Berg0162/Simcline-V3/src/config/README.md

# Central configuration

# configBoard.h
Simcline-V3 <b>Board</b> configuration options:
```C++
// Define the board here, that is part of your system setup
//#define XIAO_ESP32S3
//#define LILYGO_T_DISPLAY_S3
//#define ADAFRUIT_FEATHER_ESP32_S3
//#define ADAFRUIT_FEATHER_ESP32_V2
#define YOUR_ESP32_BOARD
```
# configDisplay.h
Simcline-V3 <b>Display</b> configuration options:
```C++
// Define the display, that is part of your system setup
#define NODISPLAY
//#define OLEDSSD1306_128x64
//#define LILYGO_T_DISPLAY_S3
//#define YOURDISPLAY
//#define SERIALDISPLAY
```
<b>Warning</b>: When a new version of Simcline-V3 is installed in Arduino IDE 2 it will override <b>ALL</b> files of a previous version! If you have made modifications in a file that is part of `Simcline-V3` --> <b>Make</b> a <b>copy</b> of the file(s) in question <b>BEFORE</b> you <b>install</b> a new library version!

# configNimBLE.h
Simcline-V3 <b>NimBLE</b> configuration options:
```C++
// ----------------------------------------------------------------------------------------
// Your FIXED hardware Laptop/Trainer/Smartphone BLE MAC- or DEVICE-Addresses 
// Enter address string here like the printed format like [00:01:02:03:04:05 0]
// LAPTOP Fixed Device Address --------Public Type (0) --------- Random Type (1)-----------
//#define LAPTOPADDRESS "00:01:02:03:04:05 0" // Example Mac string of Public Type

// TRAINER Fixed Device Address --------Public Type (0) --------- Random Type (1)----------
//#define TRAINERADDRESS "00:01:02:03:04:05 0"  // Example Mac string of Public Type

```

# configSimcline.h
Simcline-V3 <b>Mechanical SIMCLINE 2.0</b> configuration options:
```C++
//------------- Range Control definitions for high level movement control -----------------------------------------------
// In theory the RawgradeValue varies between 0 (equals -200% grade) and 40000 (equals +200% grade)
// SIMCLINE is mechanically working between -10% and +20% --> 19000 and 22000

//------------------------------------------------- WARNING --------------------------------------------------------------
//------------ SET THESE TWO VALUES IN ACCORDANCE WITH THE MECHANICAL RANGE LIMITATIONS OF YOUR SIMCLINE !!! -------------
// Raw Grade Value Minimally (Mechanically: the lowest position of wheel axis)  19000 is equiv. of 10% downhill road grade
#define RGVMIN 19500 // -5%  // Always is RGVMIN < 20000 (flat road level)
// Raw Grade Value Maximally (Mechanically: the highest position of wheel axis) 22000 is equiv. of 20% uphill road grade
#define RGVMAX 22000 // 20%  // +20% // Always is RGVMAX > 20000 (flat road level)
//------------------------------------------------- WARNING --------------------------------------------------------------

// Correction for the difference between the measuring plane and the middle
// wheel-axis position. A 1 cm offset corresponds to a MEASUREOFFSET of about 40.
#define MEASUREOFFSET 0

// -------------------------- WARNING ------------------------------------------------------------
// The following VL6180X sensor values are entirely construction specific and
// should be experimentally determined, when the Actuator AND the VL6180X sensor are mounted!
// ------>>>> Test manually and use example/test sketches that go with the VL6180X sensor! <<<<---
// Microswitches should limit physically/mechanically the upper and lower position of the Actuator!
// The microswitches are mechanically controlled, and NOT by the software --> should be fail safe!
// Notice that unrestricted movement at the boundaries can damage the Actuator and/or construction!
// The following values are respected by the software and will (in normal cases!) never be exceeded!
#define MINPOSITION 100  // VL6180X highest value top microswitch activated to mechanically stop operation
#define MAXPOSITION 200  // VL6180X lowest value bottom microswitch activated to mechanically stop operation

// -------------------------- WARNING ------------------------------------------------------------
// Operational boundaries of the VL6180X sensor are used/set in class Lifter after calling its "init".
// A safe measuring range of up to 30 cm of total movement is recommended for the VL6180X sensor setting!
//
// Bandwidth is used in the code to take measuring errors and a safe margin into account when reaching
// the above defined max or min positions of the construction! The software does painstakingly respect
// these and is independent of the appropriate working of the microswitches when reaching the boundaries!
// These microswitches are a SECOND line of defence against out of range and potentially damaging movement!
#define BANDWIDTH 4 
```
<b>Warning</b>: When a new version of Simcline-V3 is installed in Arduino IDE 2 it will override <b>ALL</b> files of a previous version! If you have made modifications in a file that is part of `Simcline-V3` --> <b>Make</b> a <b>copy</b> of the file(s) in question <b>BEFORE</b> you <b>install</b> a new library version!

# configPortal.h
Simcline-V3 <b>WiFi Portal</b> configuration options:
```C++
// Enable the startup WiFi configuration portal only on builds that have enough
// IRAM headroom for WiFi + NimBLE. Classic ESP32 builds can overflow IRAM with
// the current MITM feature set, even with a minimal WiFiServer portal.
//
// Uncomment to force-enable after testing the selected board/core combination.
//#define ENABLE_CONFIG_PORTAL

// Access Point SSID and password used by the startup configuration portal.
#define PORTAL_APPNAME 	"SimclineCfg"
#define PORTAL_PASSWORD "12345678"

// Enable automatically for newer ESP32 targets that are better suited to
// combining WiFi, NimBLE, and display code. Keep classic ESP32 excluded unless
// explicitly force-enabled above because it has shown IRAM overflow here.
#if defined(CONFIG_IDF_TARGET_ESP32S3) || \
    defined(CONFIG_IDF_TARGET_ESP32C3)  || \
    defined(CONFIG_IDF_TARGET_ESP32C5)  || \
    defined(CONFIG_IDF_TARGET_ESP32C6)  || \
    defined(CONFIG_IDF_TARGET_ESP32C61)
#define ENABLE_CONFIG_PORTAL
#endif

```

# configDebug.h
Simcline-V3 has a fine-grained scheme for allowing debug-messages during operation. Every `/src/<file name>.cpp` has its own <b>#define DEBUG</b> at the beginning of the code that can be (un)commented (switched on or off) discretionary. However, when one reaches the state that debugging has no longer a purpose, you want to get rid of all the overhead (processor load) and optimise for speed. This `configDebug.h` allows you to switch OFF in one place <b>all Simcline-V3 debugging messages</b> with one <b>master switch</b>.<br>
Simcline-V3 <b>Debug</b> configuration options:
```C++
// ------------------------------------------------------------------------------------------------
// COMPILER DIRECTIVE to allow/suppress ALL DEBUG messages that help to debug code sections
// Uncomment general "#define GLOBAL_DEBUG" to activate the Simcline-V3 debug master switch...
#define GLOBAL_DEBUG

```
