Berg0162/Simcline-V3/docs/XIAO_ESP32S3_Sense.md

# SIMCLINE Icon &nbsp; SIMCLINE-V3 for Bluetooth Smart trainers <br> based on the Seeed Studio XIAO ESP32-S3 board with OLED display.

# Setup XIAO ESP32-S3 for Simcline-V3
The board and display to work with can be activated in Simcline-V3 with the right settings.<br>
1) Open file, edit and save(!): `src/config/configBoard.h`
```C++
// ------------------------------------------------------------------------------------------------
// Define the board here, that is part of your system setup
#define XIAO_ESP32S3
//#define LILYGO_T_DISPLAY_S3
//#define ADAFRUIT_FEATHER_ESP32_S3
//#define ADAFRUIT_FEATHER_ESP32_V2
//#define YOUR_ESP32_BOARD
```
2) Open file, edit and save(!): `src/config/configDisplay.h`<br>
```C++
// ------------------------------------------------------------------------------------------------
// Define the display, that is part of your system setup
//#define NODISPLAY
#define OLEDSSD1306_128x64
//#define LILYGO_T_DISPLAY_S3
//#define YOURDISPLAY
//#define SERIALDISPLAY
// ------------------------------------------------------------------------------------------------
```
<b>Warning</b>: When a new version of Simcline-V3 is installed in Arduino IDE 2 it will override <b>ALL</b> files of a previous version! If you have made modifications in a file that is part of `Simcline-V3` --> <b>Make</b> a <b>copy</b> of the file(s) in question <b>BEFORE</b> you <b>install</b> a new library version!

## Arduino IDE 2.x
The present code is developed on Arduino IDE 2. Notice that you will need an Arduino IDE that is tailored for this specific <b>Seeed Studio XIAO ESP32-S3</b> processor! Please follow the installation instructions for the [Seeed Studio XIAO ESP32-S3](https://wiki.seeedstudio.com/xiao_esp32s3_getting_started/)<br>

## Before you start
If you select in the menu bar of Arduino IDE 2 <b>Tools</b>, the settings for the <b>XIAO_ESP32-S3</b> processor and the project are the following:
<p align=center>
XIAO_ESP32-S3 Tools Menu
</p>
<br clear="left">

# XIAO ESP32-S3 pinout

XIAO ESP32-S3 pinout

# Electronic components and wiring for the SIMCLINE 2.0 mechanical system<br>

Circuitry version 2.0

In this setup is chosen for the well-known 4 compact active components plus XIAO ESP32-S3 that are used in the SIMCLINE project and that can finally all be mounted inside the components box (designed for use with the Adafruit Feather formfactor). NOTICE: the thumb-sized XIAO ESP32-S3 needs your special care to be mounted stably inside.<br clear="right">

<b>Adafruit DRV8871 DC Motor Driver</b><br>
A small one channel motor driver for 12 V (6.5 - 48 V) and 3,6 Amperes max. This board enables the processor to set the Actuator motor in up or down movement. It transforms logical digital levels (Go Up, Go Down and Stop) from the ESP32-S3 to switching of 12 Volt at 3,6 Amperes max., the levels at which the Actuator works. Notice that default the board comes limited to 2,6 Amperes and you need to add a resistor to set for max current level. Install Vertical Through Hole Male PCB Header Pins on the board; this will allow correct mounting of the board inside the components box!<br>

<b>Seeed Studio XIAO ESP32-S3</b><br>
During years we have gained a lot of experience with the very stable and reliable <b>Seeed Studio XIAO ESP32-S3 Sense</b> - in different projects. Without the video camera the board does not need an extra heatsink is my experience!
- Powerful MCU Board: Incorporate the ESP32-S3 32-bit, dual-core, Xtensa processor chip operating up to 240 MHz, mounted multiple development ports, Arduino / MicroPython supported
- With Sense extension board: intergrating additional digital microphone (NOT USED)
- Great Memory for more Possibilities: Offer 8MB PSRAM and 8MB FLASH (16MB in Plus version), supporting SD card slot for external 32GB FAT memory (only for XIAO ESP32-S3)
- Outstanding RF performance: Support 2.4GHz Wi-Fi and BLE dual wireless communication, support 100m+ remote communication when connected with U.FL antenna
- Thumb-sized Compact Design: 21 x 17.8mm, adopting the classic form factor of XIAO, suitable for space limited projects like wearable devices
[Seeed Studio XIAO ESP32-S3](https://wiki.seeedstudio.com/xiao_esp32s3_getting_started/) <br>

<b>OLED display blue/white 128x64 pixels (0,96 Inch, I2C)</b><br>
Small display board has a critical overall board size of 25 mm * 27 mm (!); (See for example: [Webshop](https://www.gadgetbouw.nl/shop/0-96inch-128x64-i2c-oled-scherm-ssd1306-wit-of-blauw)). Display area itself is: 25 mm x 14 mm. Shows cycling data and diagnostic info that is gathered during operation by the ESP32-S3 to inform the SIMCLINE user about relevant information. NOTICE: a) Many different formfactors are offered at webshops; b) Install Vertical Through Hole Male PCB Header Pins on the board; this will allow correct mounting of the board inside the components box!<br>

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

<b>Pololu D24V5F5</b><br>
This is a small 5V, 500mA Step-Down Voltage Regulator that is responsible for voltage conversion from 12V to 5V, the power supply for all components boards. NOTICE: Install Straight Angle Through Hole Male PCB Header Pins on the board; this will allow later easy mounting of the sensor board in the components box!<br>

All components are documented very well and are low cost. There are lots of examples for use in an Arduino environment. They have turned out to be very reliable. The exact wiring of the components can be followed in the figure above.<br>
