Berg0162/Simcline-V3/docs/LILYGO ESP32S3 T-Display.md

# SIMCLINE Icon &nbsp; SIMCLINE for Bluetooth Smart Trainers <br> based on the LILYGO ESP32-S3 T-Display board <br>

## Setup LILYGO ESP32-S3 T-Display for Simcline-V3 library
The board and display to work with can be activated in Simcline-V3 with the right settings.<br>
1) Open file, edit and save(!): `src/config/configBoard.h`
```C++
// ------------------------------------------------------------------------------------------------
// Define the board here, that is part of your system setup
//#define XIAO_ESP32S3
#define LILYGO_T_DISPLAY_S3
//#define ADAFRUIT_FEATHER_ESP32_S3
//#define ADAFRUIT_FEATHER_ESP32_V2
//#define YOUR_ESP32_BOARD
```
2) Open file, edit and save(!): `src/config/configDisplay.h`<br>
```C++
// ------------------------------------------------------------------------------------------------
// Define the display, that is part of your system setup
//#define NODISPLAY
//#define OLEDSSD1306_128x64
#define LILYGO_T_DISPLAY_S3
//#define YOURDISPLAY
//#define SERIALDISPLAY
// ------------------------------------------------------------------------------------------------
```
<b>Warning</b>: When a new version of Simcline-V3 is installed in Arduino IDE 2 it will override <b>ALL</b> files of a previous version! If you have made modifications in a file that is part of `Simcline-V3` --> <b>Make</b> a <b>copy</b> of the file(s) in question <b>BEFORE</b> you <b>install</b> a new library version!

## Description
T-Display-S3 is an ESP32-S3 development board. It is equipped with a color 1.9" LCD screen and two programmable buttons. Communication using I8080 interface. Retains the same layout design as T-Display. You can directly use ESP32-S3 for USB communication or programming.

## LilyGo ESP32-S3 T-display
This board and ESP32-S3 processor was selected for its excellent specifications crisp and colorful display. Besides gaining experience with the [TFT_eSPI](https://github.com/Bodmer/TFT_eSPI) library, creating a much richer visual user interface (than a SSD1306 0,96 Inch) was the dominant incentive. A lot of inspiration and practical knowledge was obtained by studying on Youtube: [the Volos Projects](https://www.youtube.com/c/VolosProjects). This ended up so far in a good working and visually attractive Simcline 2.0 interface! What's more, in the experiments the processor was behaving like to be expected (despite the high display interface load) and I did not experience (during operation) any response difference with other ESP32 boards (with minimal display interface load) and that have been tested thoroughly...<br>
Unfortunately the LilyGo board does <b>NOT fit the original components box</b>, so that needs extra attention in the near future. Technically there is no reason so far not to like this board!!!

## Install TFT_eSPI
+ Search for <b>TFT_eSPI</b> in the Arduino IDE library manager and click <b>Install</b> or Update.
+ Enter the default library manager installation location: `C:\Users\<YourName>\Documents\Arduino\libraries`.
+ Find and open the newly created <b>TFT_eSPI</b> folder. 
+ Open `User_Setup_Select.h`, <b>comment out</b> or <b>delete</b> the line `#include <User_Setup.h>` which is enabled by default.
+ Search `Setup206_LilyGo_T_Display_S3`, find it and <b>uncomment</b> the line:
```C++
#include <User_Setups/Setup206_LilyGo_T_Display_S3.h>     // For the LilyGo T-Display S3 based ESP32-S3 with ST7789 170 x 320 TFT
```
+ Now save the file and close -> TFT_eSPI will use from now on the pin and screen definitions of `LilyGo_T-Display-S3` by default! <br>

<b>Warning</b>: When a new version of <b>TFT_eSPI</b> is installed in Arduino IDE, it will override <b>ALL</b> files of a previous version!

## Arduino IDE 2.x
The present code is developed on Arduino IDE 2.x. Notice that you will need an Arduino IDE that is tailored for this specific <b>ESP32-S3</b> processor! Please follow the installation instructions for the [ESP32-S3 T-display](https://github.com/Xinyuan-LilyGO/T-Display-S3)<br>
```
**************************************************************************************************
>>>> Select in board drop down -> ESP32S3 Dev Module    (Preferred: more specific options)    <<<<
>>>> Select in board drop down -> LilyGo T-display-S3   (Alternative with minimal options)    <<<<
>>>>         NOTICE that you have to set the appropriate settings in the Tools menu           <<<<
**************************************************************************************************
```
## Before you start
If you select in the menu bar of Arduino IDE 2.x <b>Tools</b>, the settings for the <b>ESP32S3 Dev Module</b> processor should be exactly like the following:
<p align=left>
Tools menu
</p>
<br clear="left">

## T-Display-S3 Pinout


## Quick Specs
- MCU: ESP32-S3R8 Dual-core LX7 microprocessor
- Wireless Connectivity: Wi-Fi 802.11, BLE 5 + BT mesh
- Programming Platform: Arduino-ide, Micropython
- Flash: 16MB
- PSRAM: 8MB
- Bat Voltage Detection: IO 04
- Onboard Functions: Boot + Reset + IO 14 Button
- LCD: 1.9" diagonal, Full-color TFT Display
- Drive Chip: ST7789V
- Resolution: 170(H)RGB x320(V) 8-Bit Parallel Interface
- Working Power Supply: 3.3V
- Supports: STEMMA QT / Qwiic
- Connector: JST-SH 1.0mm 4 PIN
- Dimensions: 62 x 26 x 10mm

# Electronic components and wiring for the SIMCLINE 2.0 mechanical system
<p align=left>
Circuitry version 2.0
</p>
<br clear="left">

In this project is chosen for the following 4 compact active components that are slightly different from the earlier SIMCLINE project.<br>

<b>Adafruit DRV8871 DC Motor Driver</b><br>
A small one channel motor driver for 12 V (6.5 - 48 V) and 3,6 Amperes max. This board enables the processor to set the Actuator motor in up or down movement. It transforms logical digital levels (Go Up, Go Down and Stop) from the Feather nRF52/ESP32 to switching of 12 Volt at 3,6 Amperes max., the levels at which the Actuator works. Notice that default the board comes limited to 2,6 Amperes and you need to add a resistor to set for max current level. Install Vertical Through Hole Male PCB Header Pins on the board; this will allow correct mounting of the board inside the components box!<br>

<b>LILYGO ESP32-S3 T-Display</b><br>
The programmed ESP32-S3 communicates with the trainer and the training application through the BLE MITM bridge. Before the ride, Simcline settings can be changed through the temporary startup WiFi configuration portal.<br>

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

<b>Pololu D24V5F5</b><br>
This is a small 5V, 500mA Step-Down Voltage Regulator that is responsible for voltage conversion from 12V to 5V, the power supply for all components boards. NOTICE: Install Straight Angle Through Hole Male PCB Header Pins on the board; this will allow later easy mounting of the sensor board in the components box!<br>

All components are documented very well and are low cost. There are lots of examples for use in an Arduino environment. They have turned out to be very reliable. The exact wiring of the components can be followed in the figure above.<br>

## Experimental Mechanical Setup


<br clear="left">

## Display during a ride
<br>
- Icons bar on the top shows active connections
- Actual road grade is shown in digits in the center of a gauge
- Gauge shows clockwise, positive uphill grades and counter clockwise, negative downhill grades
- Road profile is refreshed with every event (i.e. change of road grade) and shows the last 24 events
- Position in vertical color palette legend is dynamically shown
- Color palette for grade percentage is taken from [www.CylingCols.com](https://www.cyclingcols.com/col/Angliru).

<br clear="left">

## Video of display during fictional riding
Notice that the road inclination data were randomly generated (between -10 and +20) in a pace that one will never meet in the real world, just to show the interface during a long ride!
[See video on Youtube](https://www.youtube.com/watch?v=asnAkheFVb0&t=11s)
