Berg0162/Simcline-V3/docs/Setup_SIMCLINE.md

# Setup SIMCLINE following these steps:

# Independently of the Simcline-V3 library 
First test the ESP32-S3 board of your choice with the display attached to it, after you have installed Arduino IDE 2 and the appropriate graphics libraries (like Adafruit GFX and/or TFT_eSPI). Notice that you have to install the original libraries and not the modified versions that product suppliers like to include! All graphics libraries come with code examples and test these. For TFT_eSPI you need to set your display in "User_Setup_Select.h" <b>first</b> to comply with the board/display type you use. Read and study the instructions that come with the sites of these libraries! Only when you have a working combination continue...

# Setup your ESP32-S3 board for Simcline-V3
The board and display to work with can be activated in Simcline-V3 with the right settings, see folder: `src/config`<br>
The following example selects the recommended XIAO ESP32-S3 with an SSD1306 OLED display. Select exactly one board and one display appropriate for your hardware.

+ Open file, edit and save(!): `src/config/configBoard.h`
```C++
// ------------------------------------------------------------------------------------------------
// Define the board here, that is part of your system setup
#define XIAO_ESP32S3
//#define LILYGO_T_DISPLAY_S3
//#define ADAFRUIT_FEATHER_ESP32_S3
//#define ADAFRUIT_FEATHER_ESP32_V2
//#define YOUR_ESP32_BOARD
```
+ Open file, edit and save(!): `src/config/configDisplay.h`<br>

```C++
// ------------------------------------------------------------------------------------------------
// Define the display, that is part of your system setup
//#define NODISPLAY
#define OLEDSSD1306_128x64
//#define LILYGO_T_DISPLAY_S3
//#define YOURDISPLAY
//#define SERIALDISPLAY
// ------------------------------------------------------------------------------------------------
```
> Ensure that only one board macro and one display macro are enabled.<br>
+ When you want another board or display than is supplied with the standard release of Simcline-V3, a proficient programmer/user can implement Concrete Classes for ESP32-S3-board-type and Display-type of his/her choice easily without interfering with the Simcline BLE operational code. A dedicated program for creating "YOURDISPLAY" is offered in `examples/Test_Board_plus_Display` to help you with the task!

# Connect wiring of the TOF-sensor to your ESP32-S3 board
First install the <b>VL6180X</b> library in Arduino IDE 2 and the example programs that come with it. Connect using the prescribed wiring scheme depending on the board that you earlier selected: 
[Seeed Studio XIAO ESP32-S3](https://github.com/Berg0162/Simcline-V3/blob/main/docs/XIAO%20ESP32S3%20Sense.md) or
[Lilygo esp32s3 T-Display](https://github.com/Berg0162/Simcline-V3/blob/main/docs/LILYGO%20ESP32S3%20T-Display.md) or
[Adafruit Feather ESP32-S3](https://github.com/Berg0162/Simcline-V3/blob/main/docs/Adafruit%20Feather%20ESP32S3.md) <br>
Test with the supplier code examples and finally run `/Simcline-V3/examples/Test_Board_plus_VL6180X` to test in the Simcline-V3 environment.

# Connect wiring of the Motor Driver board
No library needed for <b>DRV8871</b>, but the supplier will have example code supplied. 

# Connect wiring for power regulator (5V and 12V)
# Connect the Actuator to the Motor Driver board 
Test the <b>DRV8871 plus Actuator</b> with `examples/Test_Board_plus_DRV8871`.

# Setup and mount SIMCLINE mechanically...
Actuator attached to the body and powered

# Add the TOF-sensor to the mechanical setup (in the component box)
Check it can measure the distance correctly using `examples/Test_Board_plus_VL6180X`<br>

Note down the provisional <b>MAXPOSITION</b> and <b>MINPOSITION</b> values of the TOF-sensor reaching the <b>top</b> position and <b>lowest</b> position!<br>

Open file, edit and save(!): `src/config/configSimcline.h`<br>

Insert <b>RGVMIN</b>, <b>RGVMAX</b>, <b>MINPOSITION</b> and <b>MAXPOSITION</b> values in <b>configSimcline.h</b> in accordance with your mechanical setup.

```C++
//----------- Global variable definitions for high level movement control -----------------------------------------------
// In theory the RawgradeValue varies between 0 (equals -200% grade) and 40000 (equals +200% grade)
// SIMCLINE is mechanically working between -10% and +20% --> 19000 and 22000

//------------------------------------------------- WARNING --------------------------------------------------------------
//------------ SET THESE TWO VALUES IN ACCORDANCE WITH THE MECHANICAL RANGE LIMITATIONS OF YOUR SIMCLINE !!! -------------
// Raw Grade Value Minimally (Mechanically: the lowest position of wheel axis)  19000 is equiv. of 10% downhill road grade
#define RGVMIN 19500 // -5%  // Always is RGVMIN < 20000 (flat road level)
// Raw Grade Value Maximally (Mechanically: the highest position of wheel axis) 22000 is equiv. of 20% uphill road grade
#define RGVMAX 22000 // 20%  // +20% // Always is RGVMAX > 20000 (flat road level)
//------------------------------------------------- WARNING --------------------------------------------------------------

// Correction for the difference between the measuring plane and the middle
// wheel-axis position. A 1 cm offset corresponds to a MEASUREOFFSET of about 40.
#define MEASUREOFFSET 0

// -------------------------- WARNING ------------------------------------------------------------
// The following VL6180X sensor values are entirely construction specific and
// should be experimentally determined, when the Actuator AND the VL6180X sensor are mounted!
// ------>>>> Test manually and use example/test sketches that go with the VL6180X sensor! <<<<---
// Microswitches should limit physically/mechanically the upper and lower position of the Actuator!
// The microswitches are mechanically controlled, and NOT by the software --> should be fail safe!
// Notice that unrestricted movement at the boundaries can damage the Actuator and/or construction!
// The following values are respected by the software and will (in normal cases!) never be exceeded!
#define MINPOSITION 100 // VL6180X highest value top microswitch activated to mechanically stop operation
#define MAXPOSITION 200 // VL6180X lowest value bottom microswitch activated to mechanically stop operation
```
Simcline-V3 configures the VL6180X with range scaling factor 3. This permits measurements beyond the sensor's default range at reduced resolution. Determine MINPOSITION and MAXPOSITION experimentally with the actual reflection target, lighting, mounting geometry, and mechanical limit switches.<br>
Now you should have a fully equipped and operational SIMCLINE (TOF-sensor/display/driver/Actuator) with hardware components tested separately!<br>
It is time to run `examples/Test_Fully_Equipped_Setup`.<br>
During operation of this Full-Setup test-program you will have most probably to fine-tune the <b>MINPOSITION</b> and <b>MAXPOSITION</b>. Repeat, if necessary, by editing `src/config/configSimcline.h`. **Don't forget to save the file before(!) you run the Full-Setup test-program again, otherwise the new values will not be effective!**

# Operational SIMCLINE passed the tests and is fine-tuned
Before running Smart-Simcline, first run Smart-MITM and complete a successful connection with the intended trainer and training application. Smart-MITM stores both Bluetooth addresses in NVS. Smart-Simcline then uses these stored addresses
to reconnect to the intended devices.<br>
**Smart-Simcline** reconnects to the trainer stored in NVS and advertises its mirrored server to the training application.
Smart-Simcline recognizes and tests the TOF sensor, motor-driver board, and actuator. It then reconnects to the trainer stored in NVS and advertises the mirrored trainer server to the training application. From that point onward it handles the Bluetooth MITM traffic and translates road-grade changes into actuator movements.<br>
See: [how road grades are handled FAQ #8](Frequently_Asked_Questions.md#8)<br>
See: [when devices have changed FAQ #9](Frequently_Asked_Questions.md#9)<br>

# Production build
After all testing is complete—including verification with the Serial Monitor—deactivate `GLOBAL_DEBUG` in `src/config/configDebug.h` before compiling `Smart-Simcline` for standalone operation on the SIMCLINE 2.0 mechanical system. Do this **only** for the final production build that will run without a USB connection to the computer or Arduino IDE. Only the display will give you feedback during operation!
```C++
// ------------------------------------------------------------------------------------------------
// COMPILER DIRECTIVE to allow/suppress ALL DEBUG messages that help to debug code sections
// Uncomment general "#define GLOBAL_DEBUG" to activate the Simcline-V3 debug master switch...
//#define GLOBAL_DEBUG
// ------------------------------------------------------------------------------------------------
```
# Warning 
When a new version of Simcline-V3 is installed in Arduino IDE 2 it will override <b>ALL</b> files of a previous version! If you have made modifications in a file that is part of `Simcline-V3` --> <b>Make</b> a <b>copy</b> of the file(s) in question <b>BEFORE</b> you <b>install</b> a new library version!
