Berg0162/Simcline-V3/CHANGELOG.md

# Changelog

All notable changes to this project will be documented in this file.
## [3.0.2] - 2026-11-14
### Fixed
- Quick fix of decoding properly Wahoo Kickr Core in BleWriteObserverHub::observeWrite
### Changed
### Added

## [3.0.1] - 2026-11-11
### Fixed
- Potential timimg problem of NimBLE cleanup after client disconnection
### Changed
- Advertised name (SIM32) and Scan Response name are now the same, to eliminate confusion during pairing
### Added
- Extra debugging to trace handling of Write requests 
  
## [3.0.0] - 2026-07-05
### Fixed

### Changed

### Added
- Initial release with core functionality for simulating indoor bike lifter operations.
- Complete Arduino library structure, including `src/` and `examples/` directories.
- Comprehensive `README.md` with installation and usage instructions.
- Additional detailed setup and installation instructions in `docs/` directory.

The format is based on [Keep a Changelog](https://keepachangelog.com/en/1.0.0/), 
and this project adheres to [Semantic Versioning](https://semver.org/).
