Berg0162/Simcline-V3/src/Simcline-V3.h

#pragma once

#include <Arduino.h>
#include <string.h>

static const char* CODE_VERSION = "3.0.2";

// SIMCLINE HEADER FILE----------------------------------------------------------------------------
// Include these debug utility macros in all cases!
#include "config/configDebug.h"
// ------------------------------------------------------------------------------------------------
// Board and Display headers must be reached through Simcline-V3.h
// ------------------------------------------------------------------------------------------------
// Include board specific specifications for pin assignments and setup
#include "config/configBoard.h"
// Create instance of the ESP32Board class
ESP32Board* espBoard = new ESP32Board();
// ------------------------------------------------------------------------------------------------
// Include display selection, specifications and setup
#include "config/configDisplay.h"
// ------------------------------------------------------------------------------------------------
#include "Presentation.h"
// Create instance of the Presentation class and inject the specific pDisplay object
Presentation* presentation = Presentation::getInstance(pDisplay); // !! First Call !!
// ------------------------------------------------------------------------------------------------
// Include the mechanical and logical configuration settings of the Simcline
#include "config/configSimcline.h"
// ------------------------------------------------------------------------------------------------
// Include all NimBLE related constants
#include "config/configNimBLE.h"
// ------------------------------------------------------------------------------------------------
// Include some general component
#include "Utilities.h"
// Create instance of the UTILS class
UTILS* utils = UTILS::getInstance();
// ------------------------------------------------------------------------------------------------
// Include Simcline Operations and status class
#include "Operations.h"
// Create instance of the Operations class
OPS* operations = OPS::getInstance();
// SIMCLINE HEADER FILE----------------------------------------------------------------------------
