Berg0162/Simcline-V3/examples/Test_Board_plus_Display/YOURDisplay.h

#ifndef YOURDISPLAY_H_
#define YOURDISPLAY_H_

#include <display/IDisplay.h>
static const char* IDISPLAY = "Your local Display";

// This placeholder implementation writes to USB Serial and therefore
// requires effective DEBUG until replaced with a custom display implementation.

class YOURDisplay : public IDisplay {
  private:

  public:
    YOURDisplay() {     
    }

    void initDisplay() override {
        // Replace with implementation for your display
        Serial.println("Init Display (-> Your Display)...");
        delay(1000);
    }

    void setDisplayBrightness(bool updown) override {
        // Replace with implementation for your display
        Serial.printf("Set brightness!...[%X]\n", updown);
    }

    void ShowIconsOnTopBar(bool isTrainer, bool isLaptop, bool isPhone) override {
        // Replace with implementation for your display
        Serial.printf("Trainer: [%X] ", isTrainer);
        Serial.printf("Laptop: [%X] ", isLaptop);
        Serial.printf("Phone: [%X]\n", isPhone);
    }

    void ShowMessageWindow(const String& Line1, const String& Line2, const String& Line3, uint16_t Pause) override {
        // Replace with implementation for your display
        Serial.printf("%s ", Line1);
        Serial.printf("%s ", Line2);
        Serial.printf("%s\n", Line3);
        if(Pause > 0) vTaskDelay(Pause/portTICK_PERIOD_MS); // Pause indicated time in ms
    }

    void ShowRoadGrade(float gradePerc) override {
        // Replace with implementation for your display
        Serial.printf("Roadgrade: [%5.1f]\n", gradePerc);

    }
};

// Create the Display object of type YOURDisplay
YOURDisplay* pDisplay = new YOURDisplay();

#endif // YOURDISPLAY_H_
