Berg0162/Simcline-V3/(commit log)

2026-07-07 Update Adafruit Feather ESP32S3.md
2026-07-07 Update Adafruit Feather ESP32-V2.md
2026-07-07 Update LILYGO ESP32S3 T-Display.md
