Berg0162/Simcline-V3/(notices)

Notices in the files:
README.md:
License: GPL v3
